0xCAFEDECAF/SolarMeter/(commit log)

2024-06-05 Fix weird compiler error
    [SolarMeter.ino]
2024-06-05 Consistent line terminators; remove trailig spaces; replace tabs by spaces
    [AnalogSensor.cpp, AnalogSensor.h, BaseSensor.cpp, BaseSensor.h, Exosite.ino, FerrarisSensor.cpp, FerrarisSensor.h, FlashMini.h]
2024-06-05 WatchDog.ino: increase waiting time to 3 minutes; skip waiting time when forced reset
    [WatchDog.ino]
2024-06-05 WebStuff.ino: add command 'upload'; command 'restart' now triggers immediate reboot
    [WebStuff.ino]
2024-06-05 PVoutput.ino: prevent rounding errors
    [FerrarisSensor.h, PVoutput.ino]
2024-06-05 Remove the retrieving of temperature from xml.buienradar.nl: it no longer works
    [SolarMeter.ino, userdefs_org.h]
2024-06-05 Lower Ethernet timeout to prevent watchdog trigger and other issues
    [SolarMeter.ino]
2024-06-05 Completely rewritten time-of-day handling * Add slewing to compensate very bad clock of Arduino * function 'UpdateTime' accepts parameter specifying number of attempts (default 10) * Add new function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
2026-09-18 Arduino Solar Meter Hardware Manual V11.pdf: add warning not to use 12V power supply
